pawankumardhakal/Design-and-Construction-of-PCB-Interface/Signal_Conditioning_Filtering.asc

B1: bv; V=(15/20)*(V(Vreal)+10)-7.5
C1: cap; 10n
C2: cap; 47n
C3: cap; 10n
C4: cap; 22n
R1: res; 150k
R2: res; 30k
R3: res; 150k
R4: res; 30k
R5: res; 1k
R6: res; 3.3k
R7: res; 1k
R8: res; 3.9k
R9: res; 3.3k
R10: res; 1k
R11: res; 1k
R12: res; 2.7k
R13: res; 4.7k
U1: ADTL082
U2: ADTL082
U3: ADTL082
U4: ADTL082
V1: voltage; SINE(0 10 50); AC 1 0
V2: voltage; 15
V3: voltage; 15
V4: voltage; SINE(0 0.8 8k)
Named nets: Vreal, +Vcc, -Vcc, Vo_ADC, Vsensor, Vo_Filter_MFB, Filter_Output, SK_Filter_Output, 0
.tran 0.1
MFB LOW PASS FILTER (Cut_OFF 2KHz)
ANALOG SIGNAL CONDITIONING
INVERTING AMPLIFIER FOR MFB
SALLEN-KEY LOW PASS FILTER (Cut-OFF 4 KHz)
NOISE SIGNAL
;ac dec 10 10 30000
