pawankumardhakal/Design-and-Construction-of-PCB-Interface/(list of files, drawings)

Other design files:
PCB_Working.PcbDoc
PCB_Working.PrjPcb
PCB_Working.SchDoc
